w-danford/CANable/canable-5632f7ff799a/bom.ods

Qty | Value | Package | Parts |  | Digikey
1 | BLUE | LED-0603 | LED1 | http://www.digikey.com/product-detail/en/LB%20Q39G-L2OO-35-1/475-2816-1-ND/2176355 | http://www.digikey.com/product-detail/en/LB%20Q39G-L2OO-35-1/475-2816-1-ND/2176355
1 | GREEN | LED-0603 | LED2 | http://www.digikey.com/product-detail/en/LG%20L29K-F2J1-24/475-1193-1-ND/810354 | http://www.digikey.com/product-detail/en/LG%20L29K-F2J1-24/475-1193-1-ND/810354
2 |  | 1X03_LOCK | J4, JP3 | http://www.digikey.com/product-detail/en/PREC003SAAN-RC/S1012EC-03-ND/2774851 | http://www.digikey.com/product-detail/en/PREC003SAAN-RC/S1012EC-03-ND/2774851
1 |  | SCREWTERMINAL-3.5MM-4_LOCK.007S | J3 | http://www.digikey.com/product-detail/en/1776275-4/A98038-ND/1826901 | http://www.digikey.com/product-detail/en/1776275-4/A98038-ND/1826901
1 | 820 | green-res | R2 | http://www.digikey.com/product-search/en?keywords=311-820HRCT-ND | http://www.digikey.com/product-search/en?keywords=311-820HRCT-ND
1 | 220 | Blue-res | R1 | http://www.digikey.com/product-search/en?keywords=311-220HRCT-ND | http://www.digikey.com/product-search/en?keywords=311-220HRCT-ND
3 | 10k | 0603-RES | R4 | http://www.digikey.com/product-search/en?keywords=311-10.0KHRCT-ND | http://www.digikey.com/product-search/en?keywords=311-10.0KHRCT-ND
5 | 0.1uF | 0603-CAP | C1, C2, C3, C4, C6 | http://www.digikey.com/product-search/en?keywords=1276-1006-1-ND | http://www.digikey.com/product-search/en?keywords=1276-1006-1-ND
1 | 120 | 0603-RES | R3 | http://www.digikey.com/product-search/en?keywords=311-120HRCT-ND | http://www.digikey.com/product-search/en?keywords=311-120HRCT-ND
2 | 4.7uF | 0603-CAP | C5, C7 | http://www.digikey.com/product-search/en?keywords=490-10992-1-ND | http://www.digikey.com/product-search/en?keywords=490-10992-1-ND
1 | AP2202K-3.3TRG1 | SOT23-5 | U2 | http://www.digikey.com/product-detail/en/AP2202K-3.3TRG1/AP2202K-3.3TRG1DICT-ND/4505286 | http://www.digikey.com/product-detail/en/AP2202K-3.3TRG1/AP2202K-3.3TRG1DICT-ND/4505286
1 | MCP2551 | SO08 | U3 | http://www.digikey.com/product-detail/en/MCP2551-I%2FSN/MCP2551-I%2FSN-ND/509452 | http://www.digikey.com/product-detail/en/MCP2551-I%2FSN/MCP2551-I%2FSN-ND/509452
1 | STM32F042C6T6 | LQFP48 | U$1 | http://www.digikey.com/product-search/en?vendor=0&keywords=497-14648-ND | http://www.digikey.com/product-search/en?vendor=0&keywords=497-14648-ND
1 | USB-MICROB | USB-MICROB | J2 | http://www.digikey.com/product-detail/en/10118192-0001LF/609-4613-1-ND/2785378 | http://www.digikey.com/product-detail/en/10118192-0001LF/609-4613-1-ND/2785378
1 | Fuse | F0805 | F1 | http://www.digikey.com/product-detail/en/0ZCK0035FF2G/507-1812-1-ND/4156253 | http://www.digikey.com/product-detail/en/0ZCK0035FF2G/507-1812-1-ND/4156253
2 | Jumper |  |  | http://www.digikey.com/product-detail/en/SPC02SYAN/S9001-ND/76375 | http://www.digikey.com/product-detail/en/SPC02SYAN/S9001-ND/76375
