w-danford/CANable/canable-5632f7ff799a/canable.brd

## EAGLE design canable-5632f7ff799a/canable.brd (2020-05-27)

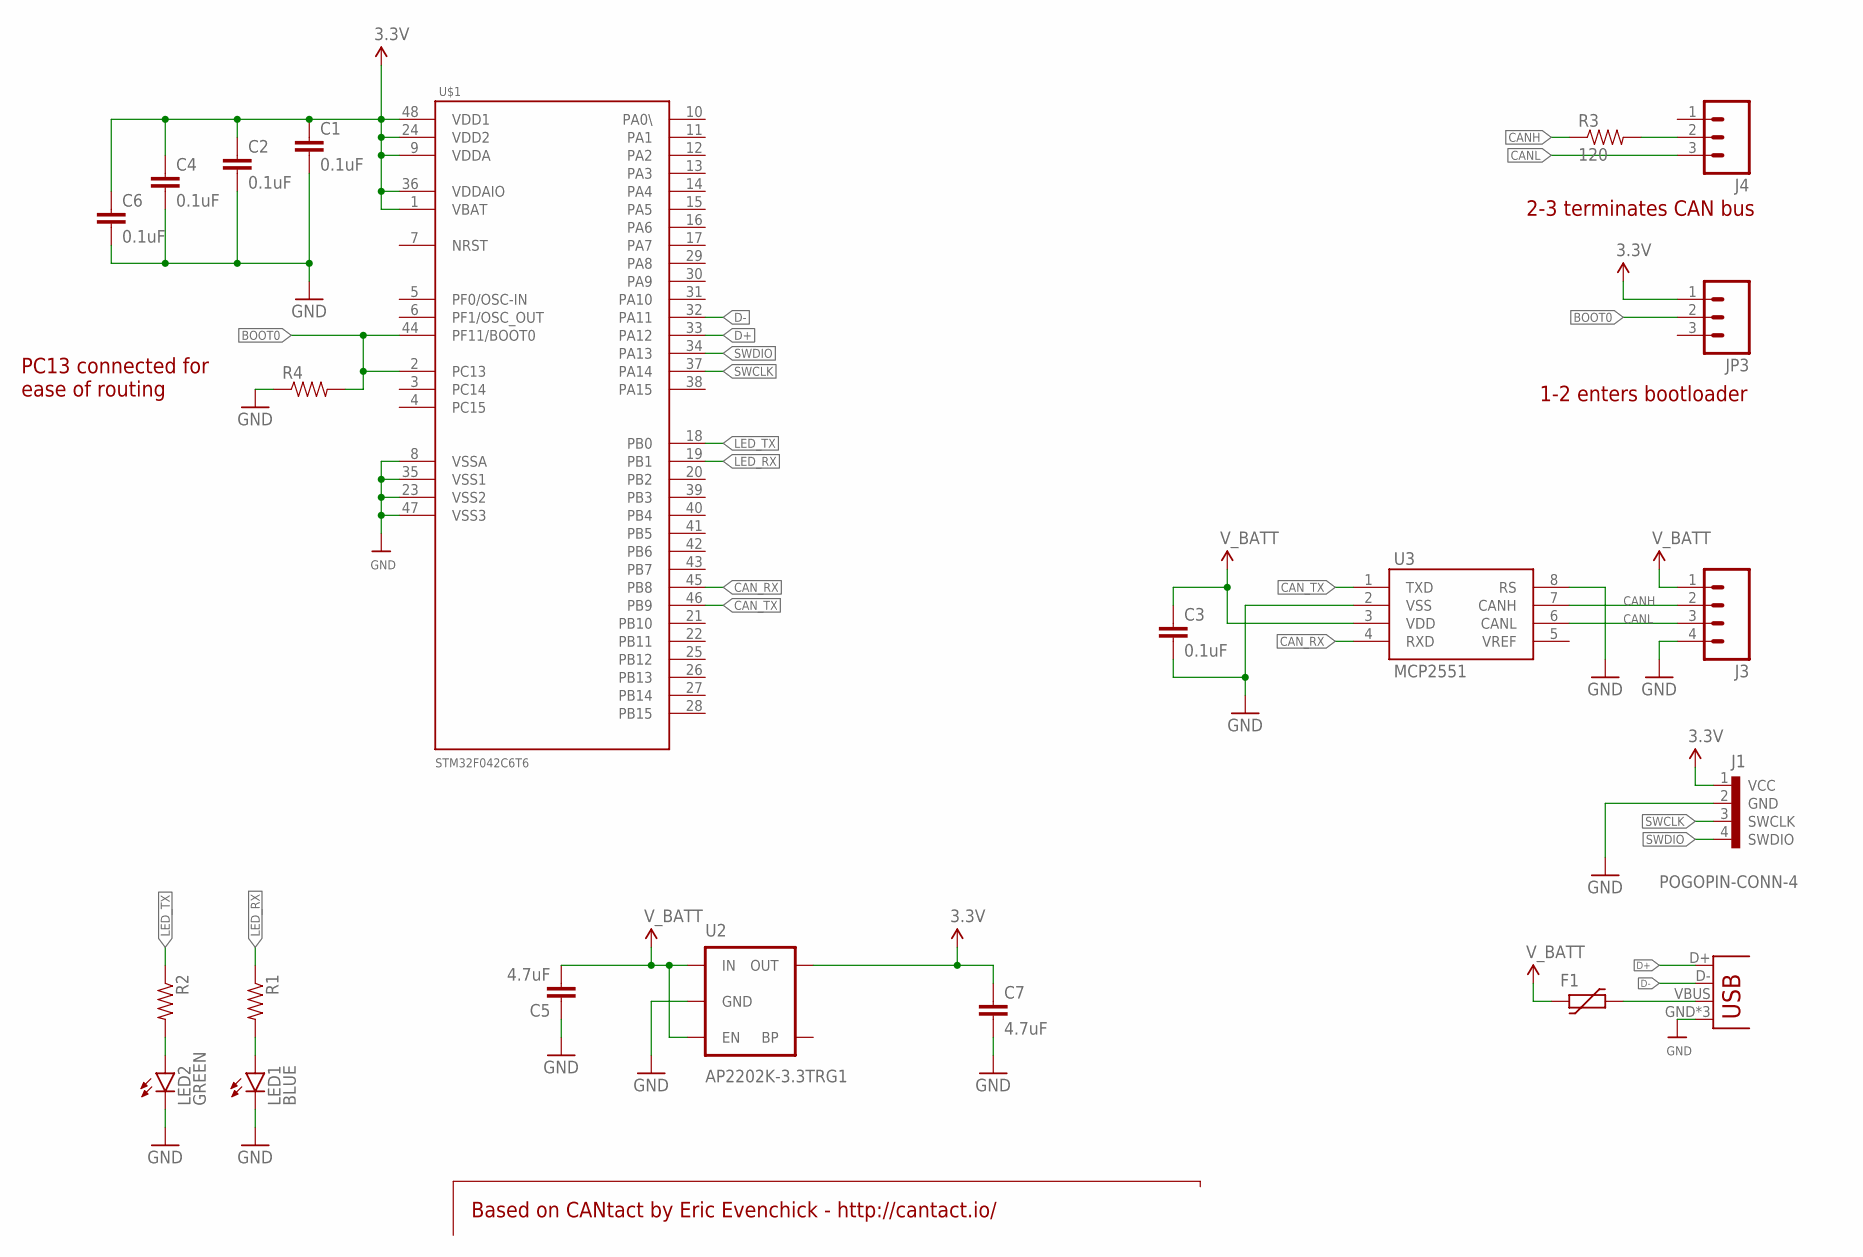
[picture p1: schematic canable.sch]

Parts:
C1, C2, C3, C4, C6: 0.1uF; 0603-CAP
C5, C7: 4.7uF; 0603-CAP
F1: FUSE_PTC-0805; PTC0805
J1: POGOPIN-CONN-4; POGOPROG-CONN-4-ALLSMT
J2: USB-MICROB
J3: M04SCREW_LOCK; SCREWTERMINAL-3.5MM-4_LOCK
J4: M03LOCK; 1X03_LOCK
JP3: M03LOCK; 1X03_LOCK
LED1: BLUE; LED-0603
LED2: GREEN; LED-0603
R1, R2, R4: RESISTOR0603-RES; 0603-RES
R3: 120; 0603-RES
U2: AP2202K-3.3TRG1; SOT23-5
U3: MCP2551; SO08
U$1: STM32F042C6T6; LQFP48

Connections:
3.3V: C1.1, C2.1, C4.1, C6.1, C7.1, J1.1 (VCC), JP3.1, U2.5 (OUT), U$1.1 (VBAT), U$1.9 (VDDA), U$1.24 (VDD2), U$1.36 (VDDAIO), U$1.48 (VDD1)
BOOT0: JP3.2, R4.2, U$1.2 (PC13), U$1.44 (PF11/BOOT0)
CANH: J3.2, R3.1, U3.7 (CANH)
CANL: J3.3, J4.3, U3.6 (CANL)
CAN_RX: U3.4 (RXD), U$1.45 (PB8)
CAN_TX: U3.1 (TXD), U$1.46 (PB9)
D+: J2.D+, U$1.33 (PA12)
D-: J2.D-, U$1.32 (PA11)
GND: C1.2, C2.2, C3.2, C4.2, C5.1, C6.2, C7.2, J1.2 (GND), J2.GND, J2.MT1 (GND), J2.MT2 (GND), J3.4, LED1.C, LED2.C, R4.1, U2.2 (GND), U3.2 (VSS), U3.8 (RS), U$1.8 (VSSA), U$1.23 (VSS2), U$1.35 (VSS1), U$1.47 (VSS3)
LED_RX: R1.1, U$1.19 (PB1)
LED_TX: R2.1, U$1.18 (PB0)
unnamed: LED2.A, R2.2
unnamed: J4.2, R3.2
unnamed: F1.2, J2.VBUS
unnamed: LED1.A, R1.2
SWCLK: J1.3 (SWCLK), U$1.37 (PA14)
SWDIO: J1.4 (SWDIO), U$1.34 (PA13)
V_BATT: C3.1, C5.2, F1.1, J3.1, U2.1 (IN), U2.3 (EN), U3.3 (VDD)

Notes on the sheet:
Based on CANtact by Eric Evenchick - http://cantact.io/
PC13 connected for ease of routing
2-3 terminates CAN bus
1-2 enters bootloader

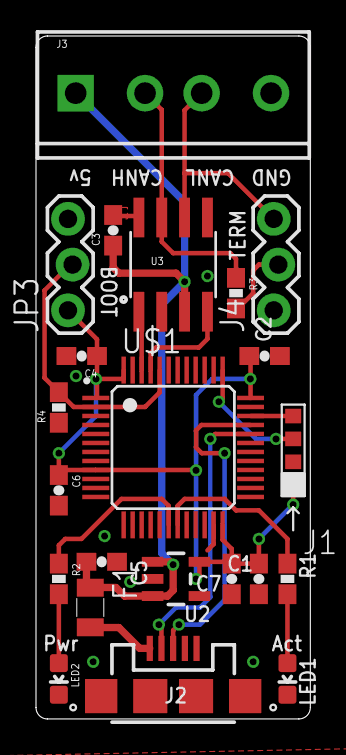
[picture p2: board canable.brd from above]

Board: 2 copper layers, 15.2 x 37.9 mm, 23 parts (1 on the bottom side), 18 nets.

Other parts of the board:
U$3: CANABLE-0.2
